CarnalMoss/Motorcontroller/motor-control/maybe-bom.xlsx

Bill of Materials |  | Senior Design |  | P16261 |  | Hardware V1 |  | 2016-01-22
Item Number | Quantity | Name /Description | web link | Quanitity Purchased | Price
Generated Using:
chdir C:\Users\terminator\Documents\classwork\senior design\repos\kicad\motor-control
C:\Program Files\KiCad\bin\xsltproc.exe -v -o outputfile.csv "C:\Program Files\KiCad\bin\scripting\plugins\bom2csv.xsl" _saved_motor-control.xml
"C:\Program Files\KiCad\bin\xsltproc.exe" -v -o motor-interface-rev1.csv "C:\Program Files\KiCad\bin\scripting\plugins\bom2csv.xsl" motor-interface-rev1.xml
 |  |  | Reference | Value | Footprint | Datasheet | Voltage
 |  |  | C1 | 470uF | Capacitors_ThroughHole:C_Radial_D16_L30_P7.5 | http://www.digikey.com/product-search/en?keywords=P5850-ND
 |  |  | C10 | 1uF | Capacitors_SMD:C_0805 |  | 6.3 V
 |  |  | C11 | 1uF | Capacitors_SMD:C_0805 |  | 10 V
 |  |  | C12 | 0.022uF | Capacitors_SMD:C_0805
 |  |  | C13 | 0.47nF | Capacitors_SMD:C_0805
 |  |  | C14 | 0.1uF | Capacitors_SMD:C_0805 |  | 10 V
 |  |  | C15 | 0.1uF | Capacitors_SMD:C_0805 |  | 16 V
 |  |  | C16 | 0.1uF | Capacitors_SMD:C_0805 |  | 100 V
 |  |  | C17 | 0.1uF | Capacitors_SMD:C_0805 |  | 16 V
 |  |  | C18 | 4.7uF | Capacitors_SMD:C_0805 |  | 100 V
 |  |  | C19 | 0.1uF | Capacitors_SMD:C_0805 |  | 16 V
 |  |  | C2 | 470uF | Capacitors_ThroughHole:C_Radial_D16_L30_P7.5 | http://www.digikey.com/product-search/en?keywords=P5850-ND
 |  |  | C20 | 47uF | Capacitors_SMD:C_0805 |  | 6.3 V
 |  |  | C21 | 4.7uF | Capacitors_SMD:C_0805 |  | 100 V
 |  |  | C3 | 470uF | Capacitors_ThroughHole:C_Radial_D16_L30_P7.5 | http://www.digikey.com/product-search/en?keywords=P5850-ND
 |  |  | C4 | 470uF | Capacitors_ThroughHole:C_Radial_D16_L30_P7.5 | http://www.digikey.com/product-search/en?keywords=P5850-ND
 |  |  | C5 | 470uF | Capacitors_ThroughHole:C_Radial_D16_L30_P7.5 | http://www.digikey.com/product-search/en?keywords=P5850-ND
 |  |  | C6 | 470uF | Capacitors_ThroughHole:C_Radial_D16_L30_P7.5 | http://www.digikey.com/product-search/en?keywords=P5850-ND
 |  |  | C7 | 2700 pF | Capacitors_SMD:C_0805
 |  |  | C8 | 6.8 pF | Capacitors_SMD:C_0805
 |  |  | C9 | 2.2uF | Capacitors_SMD:C_0805 |  | 16 V
 |  |  | D1 | D | Diodes_ThroughHole:Diode_TO-247_Vertical
 |  |  | L1 | 22uH | Inductors:INDUCTOR_V
 |  |  | P1 | CONN_02X12 | Pin_Headers:Pin_Header_Straight_2x12
 |  |  | P2 | to_motor_phase_1 | Connect:Banana_Jack_1Pin
 |  |  | P3 | to_motor_phase_2 | Connect:Banana_Jack_1Pin
 |  |  | P4 | to_motor_phase_3 | Connect:Banana_Jack_1Pin
 |  |  | P5 | CONN_01X01 | Connect:Banana_Jack_1Pin
 |  |  | P6 | CONN_01X01 | Connect:Banana_Jack_1Pin
 |  |  | P7 | CONN_01X04 | Pin_Headers:Pin_Header_Straight_1x04
 |  |  | Q1 | csd19505kcs | p16261:csd19505kcs | http://www.mouser.com/ProductDetail/Texas-Instruments/CSD19505KCS/?qs=%252bFzhjShcsaJOb21rbgU2rQ%3D%3D
 |  |  | Q10 | csd19505kcs | p16261:csd19505kcs | http://www.mouser.com/ProductDetail/Texas-Instruments/CSD19505KCS/?qs=%252bFzhjShcsaJOb21rbgU2rQ%3D%3D
 |  |  | Q11 | csd19505kcs | p16261:csd19505kcs | http://www.mouser.com/ProductDetail/Texas-Instruments/CSD19505KCS/?qs=%252bFzhjShcsaJOb21rbgU2rQ%3D%3D
 |  |  | Q12 | csd19505kcs | p16261:csd19505kcs | http://www.mouser.com/ProductDetail/Texas-Instruments/CSD19505KCS/?qs=%252bFzhjShcsaJOb21rbgU2rQ%3D%3D
 |  |  | Q2 | csd19505kcs | p16261:csd19505kcs | http://www.mouser.com/ProductDetail/Texas-Instruments/CSD19505KCS/?qs=%252bFzhjShcsaJOb21rbgU2rQ%3D%3D
 |  |  | Q3 | csd19505kcs | p16261:csd19505kcs | http://www.mouser.com/ProductDetail/Texas-Instruments/CSD19505KCS/?qs=%252bFzhjShcsaJOb21rbgU2rQ%3D%3D
 |  |  | Q4 | csd19505kcs | p16261:csd19505kcs | http://www.mouser.com/ProductDetail/Texas-Instruments/CSD19505KCS/?qs=%252bFzhjShcsaJOb21rbgU2rQ%3D%3D
 |  |  | Q5 | csd19505kcs | p16261:csd19505kcs | http://www.mouser.com/ProductDetail/Texas-Instruments/CSD19505KCS/?qs=%252bFzhjShcsaJOb21rbgU2rQ%3D%3D
 |  |  | Q6 | csd19505kcs | p16261:csd19505kcs | http://www.mouser.com/ProductDetail/Texas-Instruments/CSD19505KCS/?qs=%252bFzhjShcsaJOb21rbgU2rQ%3D%3D
 |  |  | Q7 | csd19505kcs | p16261:csd19505kcs | http://www.mouser.com/ProductDetail/Texas-Instruments/CSD19505KCS/?qs=%252bFzhjShcsaJOb21rbgU2rQ%3D%3D
 |  |  | Q8 | csd19505kcs | p16261:csd19505kcs | http://www.mouser.com/ProductDetail/Texas-Instruments/CSD19505KCS/?qs=%252bFzhjShcsaJOb21rbgU2rQ%3D%3D
 |  |  | Q9 | csd19505kcs | p16261:csd19505kcs | http://www.mouser.com/ProductDetail/Texas-Instruments/CSD19505KCS/?qs=%252bFzhjShcsaJOb21rbgU2rQ%3D%3D
 |  |  | R1 | DNP | Resistors_SMD:R_0805
 |  |  | R10 | 0R | Resistors_SMD:R_0805
 |  |  | R11 | 0R | Resistors_SMD:R_0805
 |  |  | R12 | .33R | Resistors_ThroughHole:Resistor_Vertical_RM7.5mm | http://www.mouser.com/ProductDetail/Yageo/SQP500JB-0R33/
 |  |  | R13 | .33R | Resistors_ThroughHole:Resistor_Vertical_RM7.5mm | http://www.mouser.com/ProductDetail/Yageo/SQP500JB-0R33/
 |  |  | R14 | 10R | Resistors_SMD:R_0805
 |  |  | R15 | 10R | Resistors_SMD:R_0805
 |  |  | R16 | .33R | Resistors_ThroughHole:Resistor_Vertical_RM7.5mm | http://www.mouser.com/ProductDetail/Yageo/SQP500JB-0R33/
 |  |  | R17 | 0R | Resistors_SMD:R_0805
 |  |  | R18 | 0R | Resistors_SMD:R_0805
 |  |  | R19 | .33R | Resistors_ThroughHole:Resistor_Vertical_RM7.5mm | http://www.mouser.com/ProductDetail/Yageo/SQP500JB-0R33/
 |  |  | R2 | DNP | Resistors_SMD:R_0805
 |  |  | R20 | .33R | Resistors_ThroughHole:Resistor_Vertical_RM7.5mm | http://www.mouser.com/ProductDetail/Yageo/SQP500JB-0R33/
 |  |  | R21 | .33R | Resistors_ThroughHole:Resistor_Vertical_RM7.5mm | http://www.mouser.com/ProductDetail/Yageo/SQP500JB-0R33/
 |  |  | R22 | 10R | Resistors_SMD:R_0805
 |  |  | R23 | 10R | Resistors_SMD:R_0805
 |  |  | R24 | 76.8k | Resistors_SMD:R_0805
 |  |  | R25 | 10k | Resistors_SMD:R_0805
 |  |  | R26 | 10k | Resistors_SMD:R_0805
 |  |  | R27 | 800k | Resistors_SMD:R_0805
 |  |  | R28 | 0R | Resistors_SMD:R_0805
 |  |  | R29 | 22k | Resistors_SMD:R_0805
 |  |  | R3 | 0R | Resistors_SMD:R_0805
 |  |  | R30 | 4k | Resistors_SMD:R_0805
 |  |  | R4 | 0R | Resistors_SMD:R_0805
 |  |  | R5 | .33R | Resistors_ThroughHole:Resistor_Vertical_RM7.5mm | http://www.mouser.com/ProductDetail/Yageo/SQP500JB-0R33/
 |  |  | R6 | .33R | Resistors_ThroughHole:Resistor_Vertical_RM7.5mm | http://www.mouser.com/ProductDetail/Yageo/SQP500JB-0R33/
 |  |  | R7 | 10R | Resistors_SMD:R_0805
 |  |  | R8 | 10R | Resistors_SMD:R_0805
 |  |  | R9 | .33R | Resistors_ThroughHole:Resistor_Vertical_RM7.5mm | http://www.mouser.com/ProductDetail/Yageo/SQP500JB-0R33/
 |  |  | U1 | ACS770 | p16261:ACS770xCB | http://www.digikey.com/product-search/en?keywords=ACS770LCB-050U-PFF-T
 |  |  | U2 | ACS770 | p16261:ACS770xCB | http://www.digikey.com/product-search/en?keywords=ACS770LCB-050U-PFF-T
 |  |  | U3 | ACS770 | p16261:ACS770xCB | http://www.digikey.com/product-search/en?keywords=ACS770LCB-050U-PFF-T
 |  |  | U4 | DRV8301 | p16261:DRV8301
 |  |  | U5 | ADT7301 | p16261:ADT7301
