CarnalMoss/Motorcontroller/motor-control/BOM-2-9-16-kicad-export.xlsx

Reference | Value | Footprint | Voltage | Datasheet
C8 | 0.01uF | Capacitors_SMD:C_0805 |  | http://www.mouser.com/Search/ProductDetail.aspx
C12 | 0.022uF | Capacitors_SMD:C_0805 |  | http://www.mouser.com/Search/ProductDetail.aspx
C23 | 0.047uF | Capacitors_SMD:C_0805 |  | http://www.mouser.com/ProductDetail/AVX/0805YC473KAT2A/
C25 | 0.047uF | Capacitors_SMD:C_0805 |  | http://www.mouser.com/ProductDetail/AVX/0805YC473KAT2A/
C27 | 0.047uF | Capacitors_SMD:C_0805 |  | http://www.mouser.com/ProductDetail/AVX/0805YC473KAT2A/
C14 | 0.1uF | Capacitors_SMD:C_0805 | 10 V
C15 | 0.1uF | Capacitors_SMD:C_0805 | 16 V
C17 | 0.1uF | Capacitors_SMD:C_0805 | 16 V
C19 | 0.1uF | Capacitors_SMD:C_0805 | 16 V
C22 | 0.1uF | Capacitors_SMD:C_0805 |  | http://www.mouser.com/ProductDetail/Kemet/C0805C104K3RACTU/
C24 | 0.1uF | Capacitors_SMD:C_0805 |  | http://www.mouser.com/ProductDetail/Kemet/C0805C104K3RACTU/
C26 | 0.1uF | Capacitors_SMD:C_0805 |  | http://www.mouser.com/ProductDetail/Kemet/C0805C104K3RACTU/
C13 | 0.47nF | Capacitors_SMD:C_0805
C7 | 10pF | Capacitors_SMD:C_0805 |  | http://www.mouser.com/ProductDetail/AVX/04025A100FAT2A/
C18 | 10uF | p16261:FK20X7S2A475K | 100 V | http://www.mouser.com/ProductDetail/TDK/FK20X7S2A475K/?qs=sGAEpiMZZMt3KoXD5rJ2N48tYEMqcp4xHF5PfUWuJkY%3d
C10 | 1uF | Capacitors_SMD:C_0805 | 6.3 V | http://www.mouser.com/ProductDetail/TDK/C2012X7S2A105K125AB/
C11 | 1uF | Capacitors_SMD:C_0805 | 10 V | http://www.mouser.com/ProductDetail/TDK/C2012X7S2A105K125AB/
C21 | 1uF | Capacitors_SMD:C_0805 | 100 V | http://www.mouser.com/ProductDetail/TDK/C2012X7S2A105K125AB/
C9 | 2.2uF | Capacitors_SMD:C_0805 | 16 V
C20 | 22uF | Capacitors_SMD:C_0805 | 6.3 V
C1 | 470uF | Capacitors_ThroughHole:C_Radial_D16_L30_P7.5 |  | http://www.digikey.com/product-search/en?keywords=P5850-ND
C2 | 470uF | Capacitors_ThroughHole:C_Radial_D16_L30_P7.5 |  | http://www.digikey.com/product-search/en?keywords=P5850-ND
C3 | 470uF | Capacitors_ThroughHole:C_Radial_D16_L30_P7.5 |  | http://www.digikey.com/product-search/en?keywords=P5850-ND
C4 | 470uF | Capacitors_ThroughHole:C_Radial_D16_L30_P7.5 |  | http://www.digikey.com/product-search/en?keywords=P5850-ND
C5 | 470uF | Capacitors_ThroughHole:C_Radial_D16_L30_P7.5 |  | http://www.digikey.com/product-search/en?keywords=P5850-ND
C6 | 470uF | Capacitors_ThroughHole:C_Radial_D16_L30_P7.5 |  | http://www.digikey.com/product-search/en?keywords=P5850-ND
C16 | DNP | Capacitors_SMD:C_0805 | 100 V
D1 | D | p16261:B220A-13-F |  | http://www.mouser.com/Search/ProductDetail.aspx?R=B220A-13-Fvirtualkey62110000virtualkey621-B220A-F
L1 | 68uH | p16261:PHC-27-683 |  | http://www.coilcraft.com/pdfs/pch.pdf
P5 | CONN_01X01 | Connect:Banana_Jack_1Pin
P6 | CONN_01X01 | Connect:Banana_Jack_1Pin
P7 | CONN_01X04 | Pin_Headers:Pin_Header_Straight_1x04
P1 | CONN_02X12 | Pin_Headers:Pin_Header_Straight_2x12
P2 | to_motor_phase_1 | Connect:Banana_Jack_1Pin
P3 | to_motor_phase_2 | Connect:Banana_Jack_1Pin
P4 | to_motor_phase_3 | Connect:Banana_Jack_1Pin
Q1 | csd19505kcs | p16261:csd19505kcs |  | http://www.mouser.com/ProductDetail/Texas-Instruments/CSD19505KCS/?qs=%252bFzhjShcsaJOb21rbgU2rQ%3D%3D
Q10 | csd19505kcs | p16261:csd19505kcs |  | http://www.mouser.com/ProductDetail/Texas-Instruments/CSD19505KCS/?qs=%252bFzhjShcsaJOb21rbgU2rQ%3D%3D
Q11 | csd19505kcs | p16261:csd19505kcs |  | http://www.mouser.com/ProductDetail/Texas-Instruments/CSD19505KCS/?qs=%252bFzhjShcsaJOb21rbgU2rQ%3D%3D
Q12 | csd19505kcs | p16261:csd19505kcs |  | http://www.mouser.com/ProductDetail/Texas-Instruments/CSD19505KCS/?qs=%252bFzhjShcsaJOb21rbgU2rQ%3D%3D
Q2 | csd19505kcs | p16261:csd19505kcs |  | http://www.mouser.com/ProductDetail/Texas-Instruments/CSD19505KCS/?qs=%252bFzhjShcsaJOb21rbgU2rQ%3D%3D
Q3 | csd19505kcs | p16261:csd19505kcs |  | http://www.mouser.com/ProductDetail/Texas-Instruments/CSD19505KCS/?qs=%252bFzhjShcsaJOb21rbgU2rQ%3D%3D
Q4 | csd19505kcs | p16261:csd19505kcs |  | http://www.mouser.com/ProductDetail/Texas-Instruments/CSD19505KCS/?qs=%252bFzhjShcsaJOb21rbgU2rQ%3D%3D
Q5 | csd19505kcs | p16261:csd19505kcs |  | http://www.mouser.com/ProductDetail/Texas-Instruments/CSD19505KCS/?qs=%252bFzhjShcsaJOb21rbgU2rQ%3D%3D
Q6 | csd19505kcs | p16261:csd19505kcs |  | http://www.mouser.com/ProductDetail/Texas-Instruments/CSD19505KCS/?qs=%252bFzhjShcsaJOb21rbgU2rQ%3D%3D
Q7 | csd19505kcs | p16261:csd19505kcs |  | http://www.mouser.com/ProductDetail/Texas-Instruments/CSD19505KCS/?qs=%252bFzhjShcsaJOb21rbgU2rQ%3D%3D
Q8 | csd19505kcs | p16261:csd19505kcs |  | http://www.mouser.com/ProductDetail/Texas-Instruments/CSD19505KCS/?qs=%252bFzhjShcsaJOb21rbgU2rQ%3D%3D
Q9 | csd19505kcs | p16261:csd19505kcs |  | http://www.mouser.com/ProductDetail/Texas-Instruments/CSD19505KCS/?qs=%252bFzhjShcsaJOb21rbgU2rQ%3D%3D
R12 | .33R | Resistors_ThroughHole:Resistor_Vertical_RM7.5mm |  | http://www.mouser.com/ProductDetail/Yageo/SQP500JB-0R33/
R13 | .33R | Resistors_ThroughHole:Resistor_Vertical_RM7.5mm |  | http://www.mouser.com/ProductDetail/Yageo/SQP500JB-0R33/
R16 | .33R | Resistors_ThroughHole:Resistor_Vertical_RM7.5mm |  | http://www.mouser.com/ProductDetail/Yageo/SQP500JB-0R33/
R19 | .33R | Resistors_ThroughHole:Resistor_Vertical_RM7.5mm |  | http://www.mouser.com/ProductDetail/Yageo/SQP500JB-0R33/
R20 | .33R | Resistors_ThroughHole:Resistor_Vertical_RM7.5mm |  | http://www.mouser.com/ProductDetail/Yageo/SQP500JB-0R33/
R21 | .33R | Resistors_ThroughHole:Resistor_Vertical_RM7.5mm |  | http://www.mouser.com/ProductDetail/Yageo/SQP500JB-0R33/
R5 | .33R | Resistors_ThroughHole:Resistor_Vertical_RM7.5mm |  | http://www.mouser.com/ProductDetail/Yageo/SQP500JB-0R33/
R6 | .33R | Resistors_ThroughHole:Resistor_Vertical_RM7.5mm |  | http://www.mouser.com/ProductDetail/Yageo/SQP500JB-0R33/
R9 | .33R | Resistors_ThroughHole:Resistor_Vertical_RM7.5mm |  | http://www.mouser.com/ProductDetail/Yageo/SQP500JB-0R33/
R10 | 0R | Resistors_SMD:R_0805
R11 | 0R | Resistors_SMD:R_0805
R17 | 0R | Resistors_SMD:R_0805
R18 | 0R | Resistors_SMD:R_0805
R28 | 0R | Resistors_SMD:R_0805 |  | http://www.mouser.com/ProductDetail/Panasonic/ERJ-6GEY0R00V/?qs=sGAEpiMZZMtlubZbdhIBIGGkozl1QdRpbM2mlUXXIDw%3d
R3 | 0R | Resistors_SMD:R_0805
R4 | 0R | Resistors_SMD:R_0805
R31 | 100R | Resistors_SMD:R_0805 |  | http://www.mouser.com/ProductDetail/Bourns/CRS0805-FX-1000ELF/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
R32 | 100R | Resistors_SMD:R_0805 |  | http://www.mouser.com/ProductDetail/Bourns/CRS0805-FX-1000ELF/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
R33 | 100R | Resistors_SMD:R_0805 |  | http://www.mouser.com/ProductDetail/Bourns/CRS0805-FX-1000ELF/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
R25 | 10k | Resistors_SMD:R_0805 |  | http://www.mouser.com/Search/ProductDetail.aspx
R26 | 10k | Resistors_SMD:R_0805 |  | http://www.mouser.com/Search/ProductDetail.aspx
R30 | 10k | Resistors_SMD:R_0805
R14 | 10R | Resistors_SMD:R_0805
R15 | 10R | Resistors_SMD:R_0805
R22 | 10R | Resistors_SMD:R_0805
R23 | 10R | Resistors_SMD:R_0805
R7 | 10R | Resistors_SMD:R_0805
R8 | 10R | Resistors_SMD:R_0805
R27 | 205k | Resistors_SMD:R_0603 |  | http://www.mouser.com/Search/ProductDetail.aspx
R24 | 24.3k | Resistors_SMD:R_0805
R29 | 53.6k | Resistors_SMD:R_0805
R1 | DNP | Resistors_SMD:R_0805
R2 | DNP | Resistors_SMD:R_0805
U1 | ACS770 | p16261:ACS770xCB |  | http://www.digikey.com/product-search/en?keywords=ACS770LCB-050U-PFF-T
U2 | ACS770 | p16261:ACS770xCB |  | http://www.digikey.com/product-search/en?keywords=ACS770LCB-050U-PFF-T
U3 | ACS770 | p16261:ACS770xCB |  | http://www.digikey.com/product-search/en?keywords=ACS770LCB-050U-PFF-T
U5 | ADT7301 | p16261:ADT7301
U4 | DRV8301 | p16261:DRV8301
