CarnalMoss/Motorcontroller/motor-interface/motor-interface-rev1.csv

Reference | Value | Footprint | Datasheet
C1 | .47uF | Capacitors_Tantalum_SMD:TantalC_SizeB_EIA-3528_Reflow | http://www.mouser.com/ProductDetail/AVX/TCJB474M063R0400/
C2 | 100uF | Capacitors_Tantalum_SMD:TantalC_SizeA_EIA-3216_Reflow | http://www.mouser.com/ProductDetail/Panasonic/6TPH100MAEA/
D1 | YELLOW | LEDs:LED-0805 | http://www.mouser.com/Search/ProductDetail.aspx
D2 | RED | LEDs:LED-0805 | http://www.mouser.com/Search/ProductDetail.aspx
D3 | GREEN | LEDs:LED-0805 | http://www.mouser.com/Search/ProductDetail.aspx
D4 | GREEN | LEDs:LED-0805 | http://www.mouser.com/Search/ProductDetail.aspx
P1 | CONN_02X12 | Pin_Headers:Pin_Header_Straight_2x12
P10 | CONN_01X03 | Pin_Headers:Pin_Header_Straight_1x03
P11 | CONN_01X04 | Pin_Headers:Pin_Header_Straight_1x04
P12 | CONN_01X03 | Pin_Headers:Pin_Header_Straight_1x03
P13 | CONN_01X03 | Pin_Headers:Pin_Header_Straight_1x03
P2 | CONN_02X10 | Pin_Headers:Pin_Header_Straight_2x10
P3 | CONN_01X03 | Pin_Headers:Pin_Header_Straight_1x03
P4 | CONN_02X10 | Pin_Headers:Pin_Header_Straight_2x10
P5 | CONN_01X04 | Pin_Headers:Pin_Header_Straight_1x04
P6 | CONN_01X04 | Pin_Headers:Pin_Header_Straight_1x04
P7 | CONN_01X04 | Pin_Headers:Pin_Header_Straight_1x04
P8 | CONN_01X01 | Pin_Headers:Pin_Header_Straight_1x01
P9 | CONN_01X03 | Pin_Headers:Pin_Header_Straight_1x03
Q1 | SI2325DS-T1-E3 | p16261:SI2325DS-T1-E3 | http://www.mouser.com/Search/ProductDetail.aspx
Q2 | SI2325DS-T1-E3 | p16261:SI2325DS-T1-E3 | http://www.mouser.com/Search/ProductDetail.aspx
R1 | 330R | Resistors_SMD:R_0603 | http://www.mouser.com/ProductDetail/Vishay-Dale/CRCW0603330RFKEAHP/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
R2 | 330R | Resistors_SMD:R_0603 | http://www.mouser.com/ProductDetail/Vishay-Dale/CRCW0603330RFKEAHP/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
R3 | EN_SO1 | Resistors_SMD:R_0603 | http://www.mouser.com/ProductDetail/Vishay-Dale/CRCW06030000Z0EA/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
R4 | EN_SO2 | Resistors_SMD:R_0603 | http://www.mouser.com/ProductDetail/Vishay-Dale/CRCW06030000Z0EA/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
R5 | 500R | Resistors_SMD:R_0603 | http://www.mouser.com/ProductDetail/Vishay-Dale/CRCW0603510RFKEA/
R6 | 330R | Resistors_SMD:R_0603 | http://www.mouser.com/ProductDetail/Vishay-Dale/CRCW0603330RFKEAHP/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
RV1 | POT | p16261:3361P | http://www.mouser.com/Search/ProductDetail.aspx
RV2 | POT | p16261:3361P | http://www.mouser.com/Search/ProductDetail.aspx
RV3 | POT | p16261:3361P | http://www.mouser.com/Search/ProductDetail.aspx
RV4 | POT | p16261:3361P | http://www.mouser.com/Search/ProductDetail.aspx
RV5 | POT | p16261:3361P | http://www.mouser.com/Search/ProductDetail.aspx
RV6 | POT | p16261:3361P | http://www.mouser.com/Search/ProductDetail.aspx
RV7 | POT | p16261:3361P | http://www.mouser.com/Search/ProductDetail.aspx
U1 | SN74LV1T34 | p16261:SN74LV1T34 | http://www.mouser.com/Search/ProductDetail.aspx
U2 | SN74LV1T34 | p16261:SN74LV1T34 | http://www.mouser.com/Search/ProductDetail.aspx
U3 | LM3940IS-3.3 | p16261:LM3940IS-3.3 | http://www.mouser.com/ProductDetail/Texas-Instruments/LM3940IS-33-NOPB/
U4 | SN74LV1T34 | p16261:SN74LV1T34 | http://www.mouser.com/Search/ProductDetail.aspx
U5 | SN74LV1T34 | p16261:SN74LV1T34 | http://www.mouser.com/Search/ProductDetail.aspx
U6 | SN74LV1T34 | p16261:SN74LV1T34 | http://www.mouser.com/Search/ProductDetail.aspx
U7 | SN74LV1T34 | p16261:SN74LV1T34 | http://www.mouser.com/Search/ProductDetail.aspx
U8 | SN74LV1T34 | p16261:SN74LV1T34 | http://www.mouser.com/Search/ProductDetail.aspx
U9 | SN74LV1T34 | p16261:SN74LV1T34 | http://www.mouser.com/Search/ProductDetail.aspx
