CarnalMoss/Motorcontroller/motor-interface/motor-interface-rev1.kicad_pcb

## KiCad design motor-interface/motor-interface-rev1.kicad_pcb (2016-04-03)

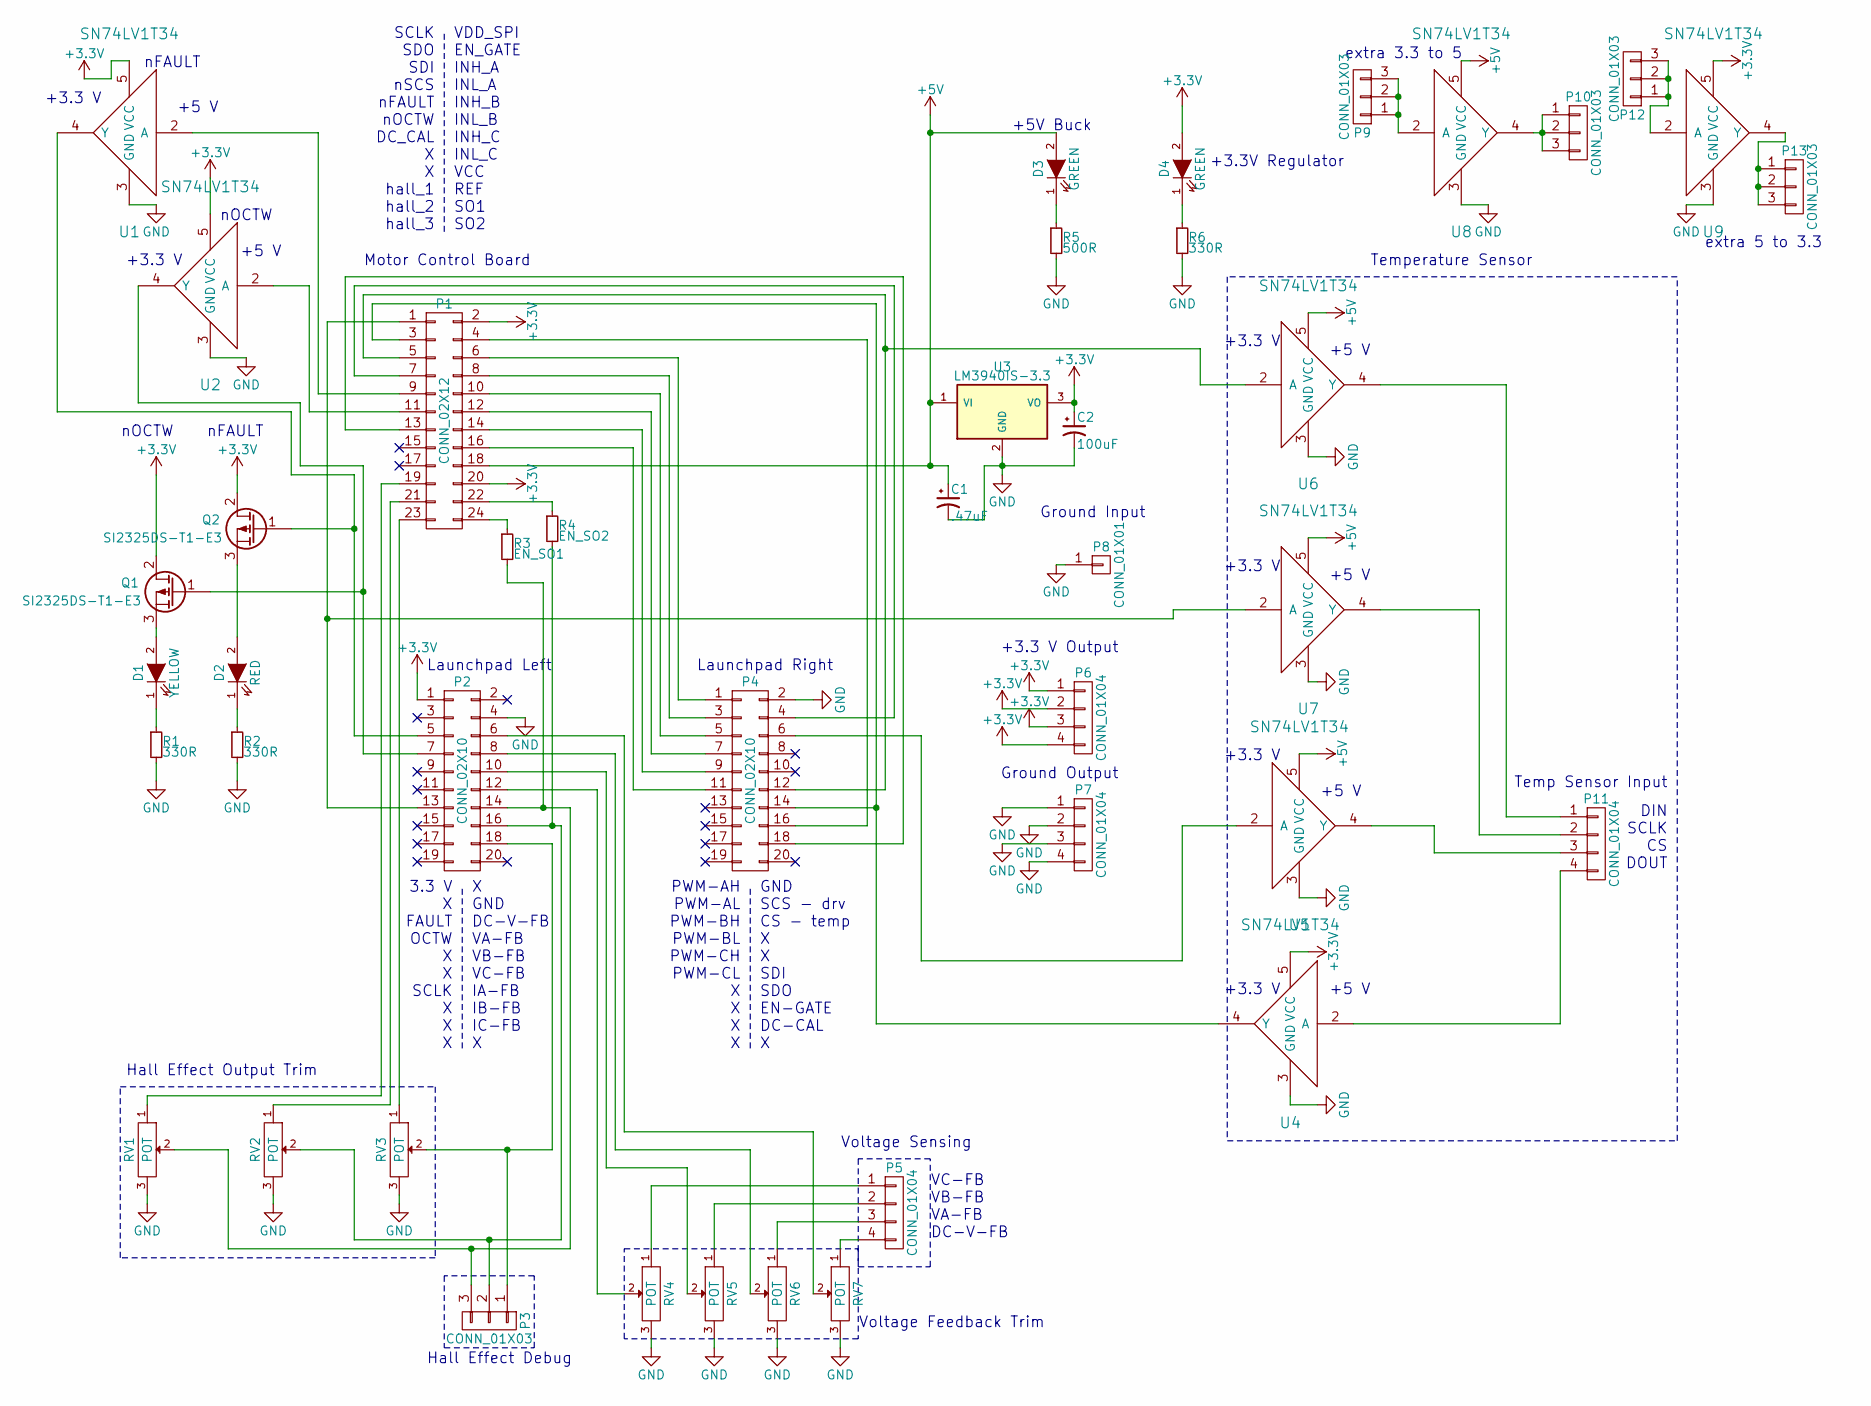
[picture p1: schematic motor-interface-rev1.sch, Motor Controller Interface Board]

Parts:
C1: .47uF; TantalC_SizeB_EIA-3528_Reflow
C2: 100uF; TantalC_SizeA_EIA-3216_Reflow
D1: YELLOW; LED-0805
D2: RED; LED-0805
D3, D4: GREEN; LED-0805
P1: CONN_02X12; Pin_Header_Straight_2x12
P2, P4: CONN_02X10; Pin_Header_Straight_2x10
P3, P9, P10, P12, P13: CONN_01X03; Pin_Header_Straight_1x03
P5, P6, P7, P11: CONN_01X04; Pin_Header_Straight_1x04
P8: CONN_01X01; Pin_Header_Straight_1x01
Q1, Q2: SI2325DS-T1-E3
R1, R2, R6: 330R; R_0603
R3: EN_SO1; R_0603
R4: EN_SO2; R_0603
R5: 500R; R_0603
RV1, RV2, RV3, RV4, RV5, RV6, RV7: POT; 3361P
U1, U2, U4, U5, U6, U7, U8, U9: SN74LV1T34
U3: LM3940IS-3.3

Connections:
+3V3: C2.1, D4.2 (A), P1.2, P1.20, P2.1, P6.1, P6.2, P6.3, P6.4, Q1.2 (D), Q2.2 (D), U1.5 (VCC), U2.5 (VCC), U3.3 (VO), U4.5 (VCC), U9.5 (VCC)
+5V: C1.1, D3.2 (A), P1.18, U3.1 (VI), U5.5 (VCC), U6.5 (VCC), U7.5 (VCC), U8.5 (VCC)
GND: C1.2, C2.2, P2.4, P4.2, P7.1, P7.2, P7.3, P7.4, P8.1, R1.2, R2.2, R5.2, R6.2, RV1.3, RV2.3, RV3.3, RV4.3, RV5.3, RV6.3, RV7.3, U1.3 (GND), U2.3 (GND), U3.2 (GND), U4.3 (GND), U5.3 (GND), U6.3 (GND), U7.3 (GND), U8.3 (GND), U9.3 (GND)
unnamed: D1.1 (K), R1.1
unnamed: D1.2 (A), Q1.3 (S)
unnamed: D2.1 (K), R2.1
unnamed: D2.2 (A), Q2.3 (S)
unnamed: D3.1 (K), R5.1
unnamed: D4.1 (K), R6.1
unnamed: P1.1, P2.13, U7.2 (A)
unnamed: P1.3, P4.14, U4.4 (Y)
unnamed: P1.4, P4.16
unnamed: P1.5, P4.12, U6.2 (A)
unnamed: P1.6, P4.1
unnamed: P1.7, P4.4
unnamed: P1.8, P4.3
unnamed: P1.9, U1.2 (A)
unnamed: P1.10, P4.5
unnamed: P1.11, U2.2 (A)
unnamed: P1.12, P4.7
unnamed: P1.13, P4.18
unnamed: P1.14, P4.9
unnamed: P1.16, P4.11
unnamed: P1.19, RV1.1
unnamed: P1.21, RV2.1
unnamed: P1.22, R4.1
unnamed: P1.23, RV3.1
unnamed: P1.24, R3.1
unnamed: P2.5, Q2.1 (G), U1.4 (Y)
unnamed: P2.6, RV7.2
unnamed: P2.7, Q1.1 (G), U2.4 (Y)
unnamed: P2.8, RV6.2
unnamed: P2.10, RV5.2
unnamed: P2.12, RV4.2
unnamed: P2.14, P3.3, R3.2, RV1.2
unnamed: P2.16, P3.2, R4.2, RV2.2
unnamed: P2.18, P3.1, RV3.2
unnamed: P4.6, U5.2 (A)
unnamed: P5.1, RV4.1
unnamed: P5.2, RV5.1
unnamed: P5.3, RV6.1
unnamed: P5.4, RV7.1
unnamed: P9.1, P9.2, P9.3, U8.2 (A)
unnamed: P10.1, P10.2, P10.3, U8.4 (Y)
unnamed: P11.1, U6.4 (Y)
unnamed: P11.2, U7.4 (Y)
unnamed: P11.3, U5.4 (Y)
unnamed: P11.4, U4.2 (A)
unnamed: P12.1, P12.2, P12.3, U9.2 (A)
unnamed: P13.1, P13.2, P13.3, U9.4 (Y)

Notes on the sheet:
X GND DC-V-FB VA-FB VB-FB VC-FB IA-FB IB-FB IC-FB X
3.3 V X FAULT OCTW X X SCLK X X X
GND SCS - drv CS - temp X X SDI SDO EN-GATE DC-CAL X
PWM-AH PWM-AL PWM-BH PWM-BL PWM-CH PWM-CL X X X X
VDD_SPI EN_GATE INH_A INL_A INH_B INL_B INH_C INL_C VCC REF SO1 SO2
SCLK SDO SDI nSCS nFAULT nOCTW DC_CAL X X hall_1 hall_2 hall_3
Ground Input
+3.3 V Output
Ground Output
Temp Sensor Input
DIN SCLK CS DOUT
Temperature Sensor
+3.3 V
+5 V
Hall Effect Output Trim
nOCTW
nFAULT
Hall Effect Debug
Voltage Sensing
VC-FB VB-FB VA-FB DC-V-FB
Voltage Feedback Trim
+5V Buck
+3.3V Regulator
Launchpad Left
Launchpad Right
Motor Control Board
extra 3.3 to 5
extra 5 to 3.3

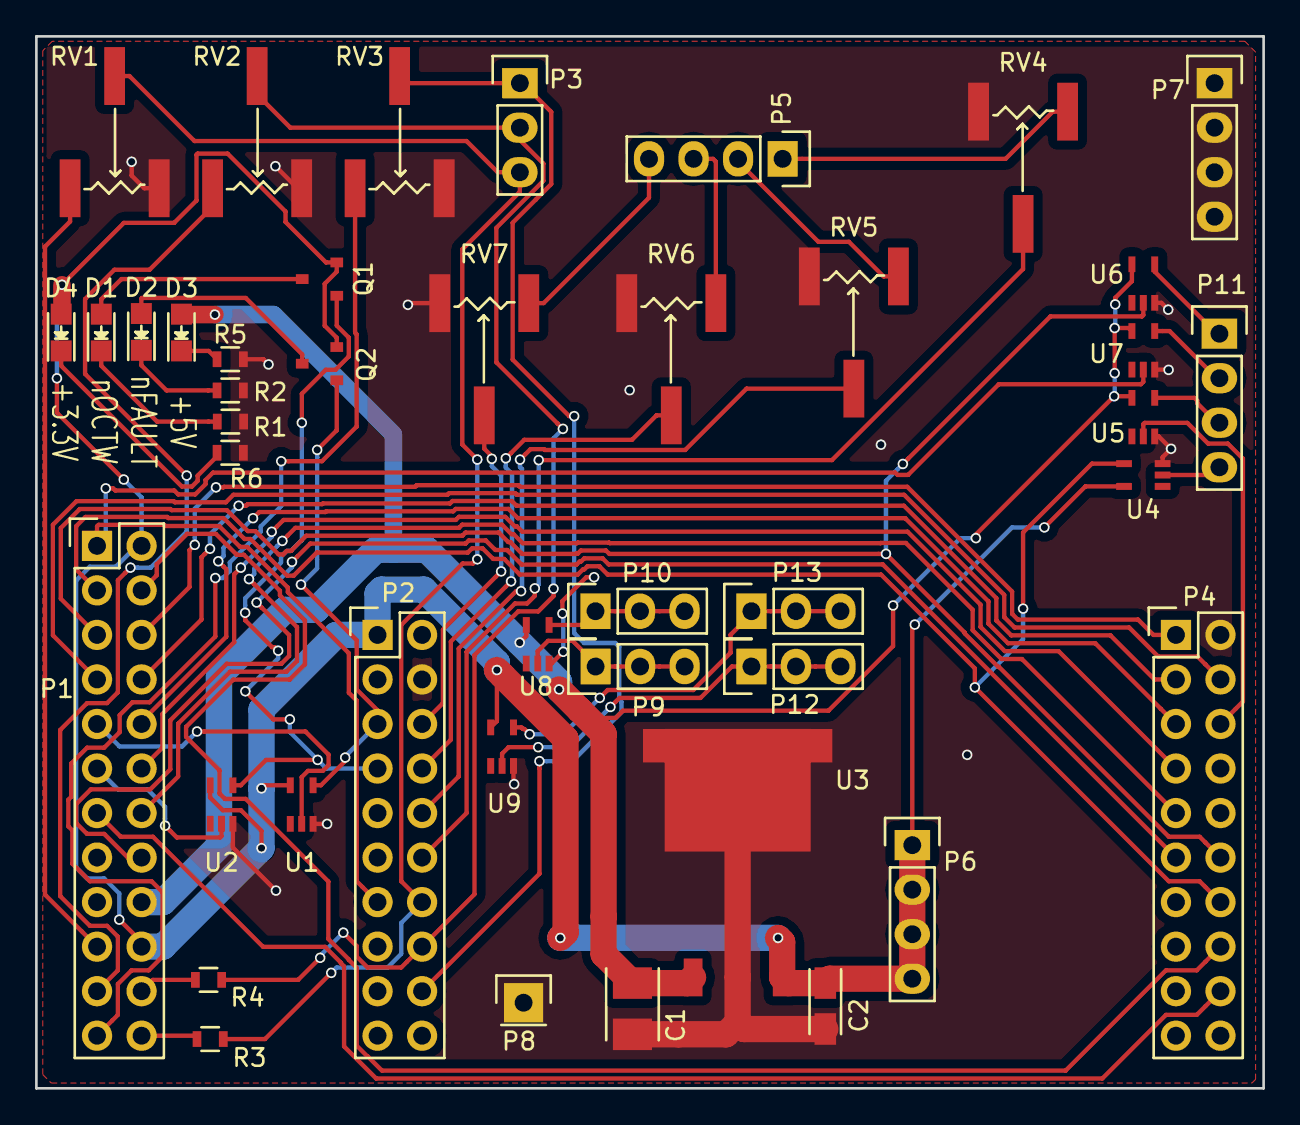
[picture p2: board motor-interface-rev1.kicad_pcb from above]

Board: 2 copper layers, 70.0 x 60.0 mm, 43 parts (0 on the bottom side), 50 nets.
