CarnalMoss/Motorcontroller/motor-control/_saved_motor-control.kicad_pcb

## KiCad design motor-control/_saved_motor-control.kicad_pcb (2015-12-08)

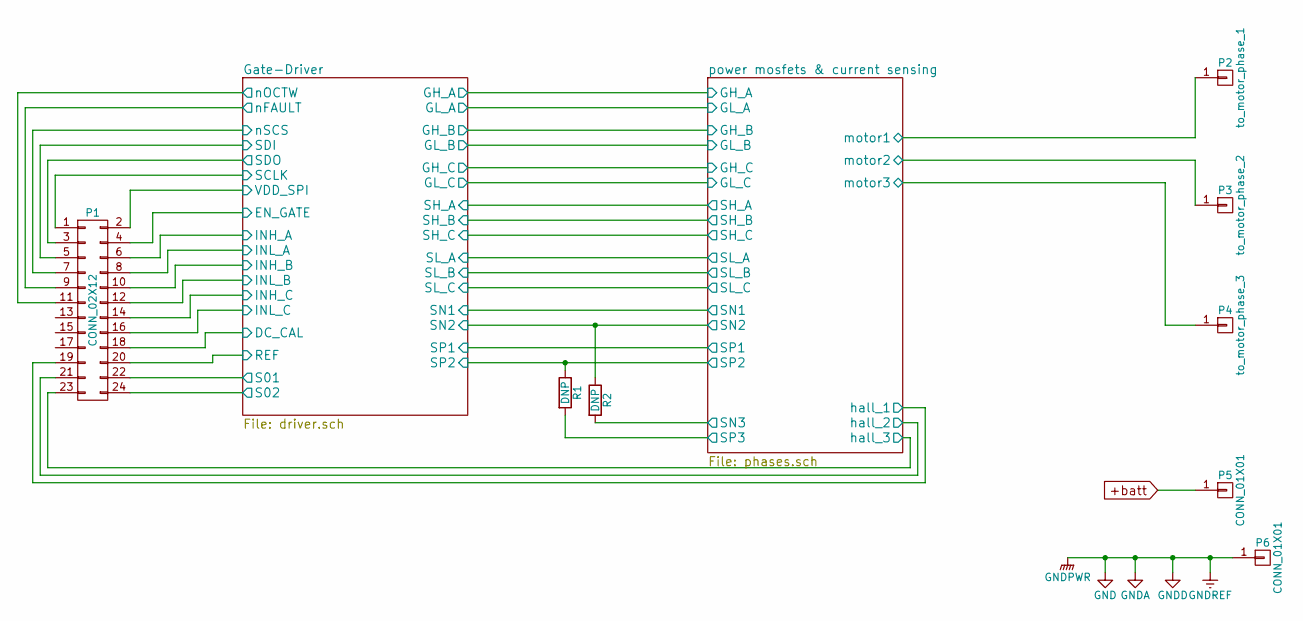
[picture p3: schematic _saved_motor-control.sch, P16261 Motor Controller Schematic -- Top Level]

Parts:
P1: CONN_02X12; Pin_Header_Straight_2x12
P2: to_motor_phase_1; Banana_Jack_1Pin
P3: to_motor_phase_2; Banana_Jack_1Pin
P4: to_motor_phase_3; Banana_Jack_1Pin
P5, P6: CONN_01X01; Pin_Header_Straight_1x01
R1, R2: DNP; R_0805

Connections:
+batt: P5.1; also elsewhere on the board
/Gate-Driver/DC_CAL: P1.18; also elsewhere on the board
/Gate-Driver/EN_GATE: P1.4; also elsewhere on the board
/Gate-Driver/INH_A: P1.6; also elsewhere on the board
/Gate-Driver/INH_B: P1.10; also elsewhere on the board
/Gate-Driver/INH_C: P1.14; also elsewhere on the board
/Gate-Driver/INL_A: P1.8; also elsewhere on the board
/Gate-Driver/INL_B: P1.12; also elsewhere on the board
/Gate-Driver/INL_C: P1.16; also elsewhere on the board
/Gate-Driver/REF: P1.20; also elsewhere on the board
/Gate-Driver/S01: P1.22; also elsewhere on the board
/Gate-Driver/S02: P1.24; also elsewhere on the board
/Gate-Driver/SCLK: P1.1; also elsewhere on the board
/Gate-Driver/SDI: P1.5; also elsewhere on the board
/Gate-Driver/SDO: P1.3; also elsewhere on the board
/Gate-Driver/SH_A: P2.1; also elsewhere on the board
/Gate-Driver/SH_B: P3.1; also elsewhere on the board
/Gate-Driver/SH_C: P4.1; also elsewhere on the board
/Gate-Driver/SN2: R2.1; also elsewhere on the board
/Gate-Driver/SP2: R1.1; also elsewhere on the board
/Gate-Driver/VDD_SPI: P1.2; also elsewhere on the board
/Gate-Driver/nFault: P1.9; also elsewhere on the board
/Gate-Driver/nOCTW: P1.11; also elsewhere on the board
/Gate-Driver/nSCS: P1.7; also elsewhere on the board
/power mosfets & current sensing/SN3: R2.2; also elsewhere on the board
/power mosfets & current sensing/SP3: R1.2; also elsewhere on the board
/power mosfets & current sensing/hall_1: P1.19; also elsewhere on the board
/power mosfets & current sensing/hall_2: P1.21; also elsewhere on the board
/power mosfets & current sensing/hall_3: P1.23; also elsewhere on the board
GND: P6.1; also elsewhere on the board

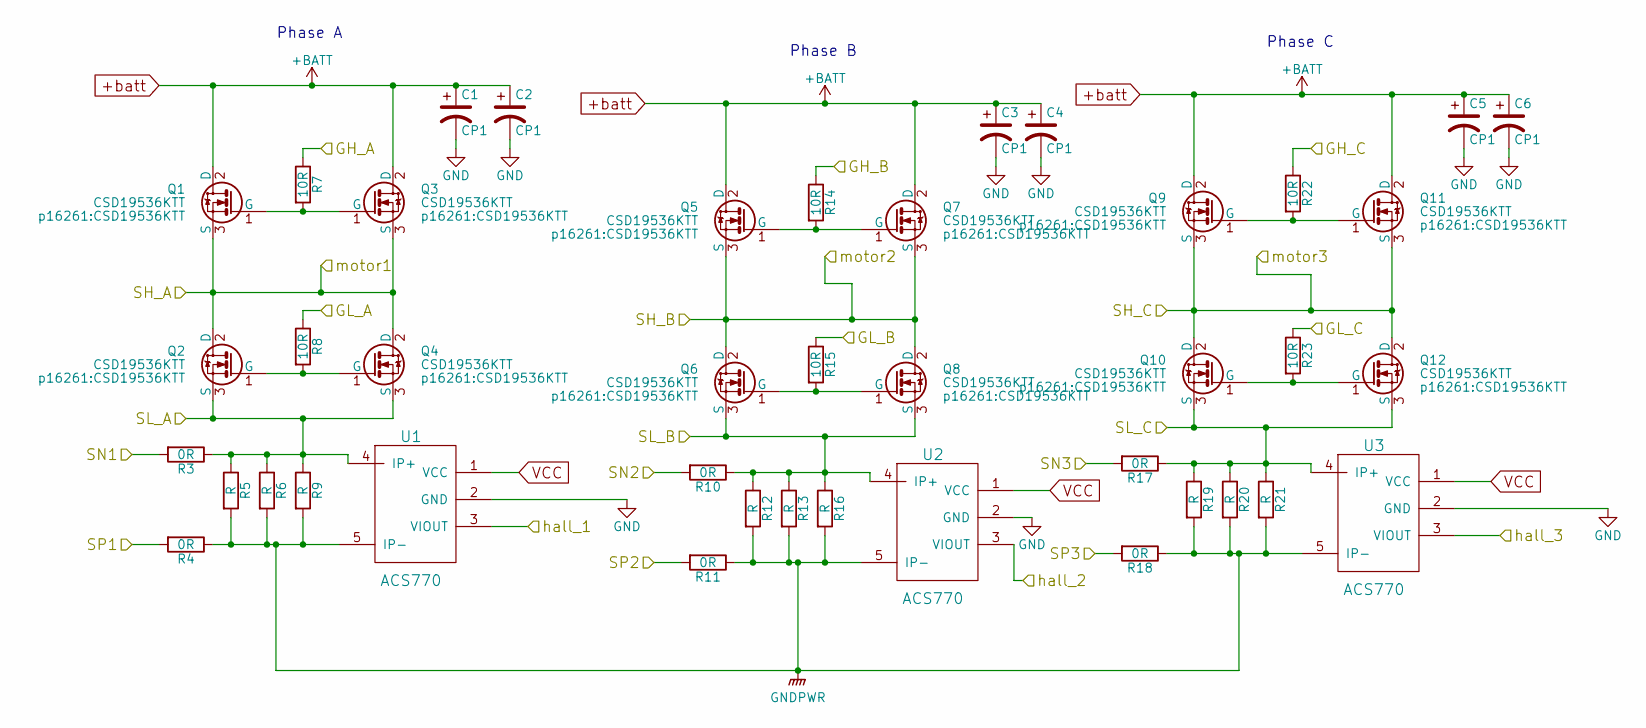
[picture p4: schematic phases.sch, Power MOSFETs]

Parts:
C1, C2, C3, C4, C5, C6: CP1; Elko_vert_31.5x16mm_RM7.5
Q1, Q2, Q3, Q4, Q5, Q6, Q7, Q8, Q9, Q10, Q11, Q12: CSD19536KTT
R3, R4, R10, R11, R17, R18: 0R; R_0805
R5, R6, R9, R12, R13, R16, R19, R20, R21: R; R_0805
R7, R8, R14, R15, R22, R23: 10R; R_0805
U1, U2, U3: ACS770; ACS770xCB

Connections:
+batt: C1.1, C2.1, C3.1, C4.1, C5.1, C6.1, Q1.2 (D), Q3.2 (D), Q5.2 (D), Q7.2 (D), Q9.2 (D), Q11.2 (D); also elsewhere on the board
/Gate-Driver/GH_A: R7.1; also elsewhere on the board
/Gate-Driver/GH_B: R14.1; also elsewhere on the board
/Gate-Driver/GH_C: R22.1; also elsewhere on the board
/Gate-Driver/GL_A: R8.1; also elsewhere on the board
/Gate-Driver/GL_B: R15.1; also elsewhere on the board
/Gate-Driver/GL_C: R23.1; also elsewhere on the board
/Gate-Driver/SH_A: Q1.3 (S), Q2.2 (D), Q3.3 (S), Q4.2 (D); also elsewhere on the board
/Gate-Driver/SH_B: Q5.3 (S), Q6.2 (D), Q7.3 (S), Q8.2 (D); also elsewhere on the board
/Gate-Driver/SH_C: Q9.3 (S), Q10.2 (D), Q11.3 (S), Q12.2 (D); also elsewhere on the board
/Gate-Driver/SL_A: Q2.3 (S), Q4.3 (S), R3.1, R5.1, R6.1, R9.1, U1.4 (IP+); also elsewhere on the board
/Gate-Driver/SL_B: Q6.3 (S), Q8.3 (S), R10.1, R12.1, R13.1, R16.1, U2.4 (IP+); also elsewhere on the board
/Gate-Driver/SL_C: Q10.3 (S), Q12.3 (S), R17.1, R19.1, R20.1, R21.1, U3.4 (IP+); also elsewhere on the board
/Gate-Driver/SN1: R3.2; also elsewhere on the board
/Gate-Driver/SN2: R10.2; also elsewhere on the board
/Gate-Driver/SP1: R4.2; also elsewhere on the board
/Gate-Driver/SP2: R11.2; also elsewhere on the board
/power mosfets & current sensing/SN3: R17.2; also elsewhere on the board
/power mosfets & current sensing/SP3: R18.2; also elsewhere on the board
/power mosfets & current sensing/hall_1: U1.3 (VIOUT); also elsewhere on the board
/power mosfets & current sensing/hall_2: U2.3 (VIOUT); also elsewhere on the board
/power mosfets & current sensing/hall_3: U3.3 (VIOUT); also elsewhere on the board
GND: C1.2, C2.2, C3.2, C4.2, C5.2, C6.2, R4.1, R5.2, R6.2, R9.2, R11.1, R12.2, R13.2, R16.2, R18.1, R19.2, R20.2, R21.2, U1.2 (GND), U1.5 (IP-), U2.2 (GND), U2.5 (IP-), U3.2 (GND), U3.5 (IP-); also elsewhere on the board
unnamed: Q1.1 (G), Q3.1 (G), R7.2
unnamed: Q2.1 (G), Q4.1 (G), R8.2
unnamed: Q5.1 (G), Q7.1 (G), R14.2
unnamed: Q6.1 (G), Q8.1 (G), R15.2
unnamed: Q10.1 (G), Q12.1 (G), R23.2
unnamed: Q9.1 (G), Q11.1 (G), R22.2
VCC: U1.1 (VCC), U2.1 (VCC), U3.1 (VCC); also elsewhere on the board

Notes on the sheet:
Phase A
Phase B
Phase C

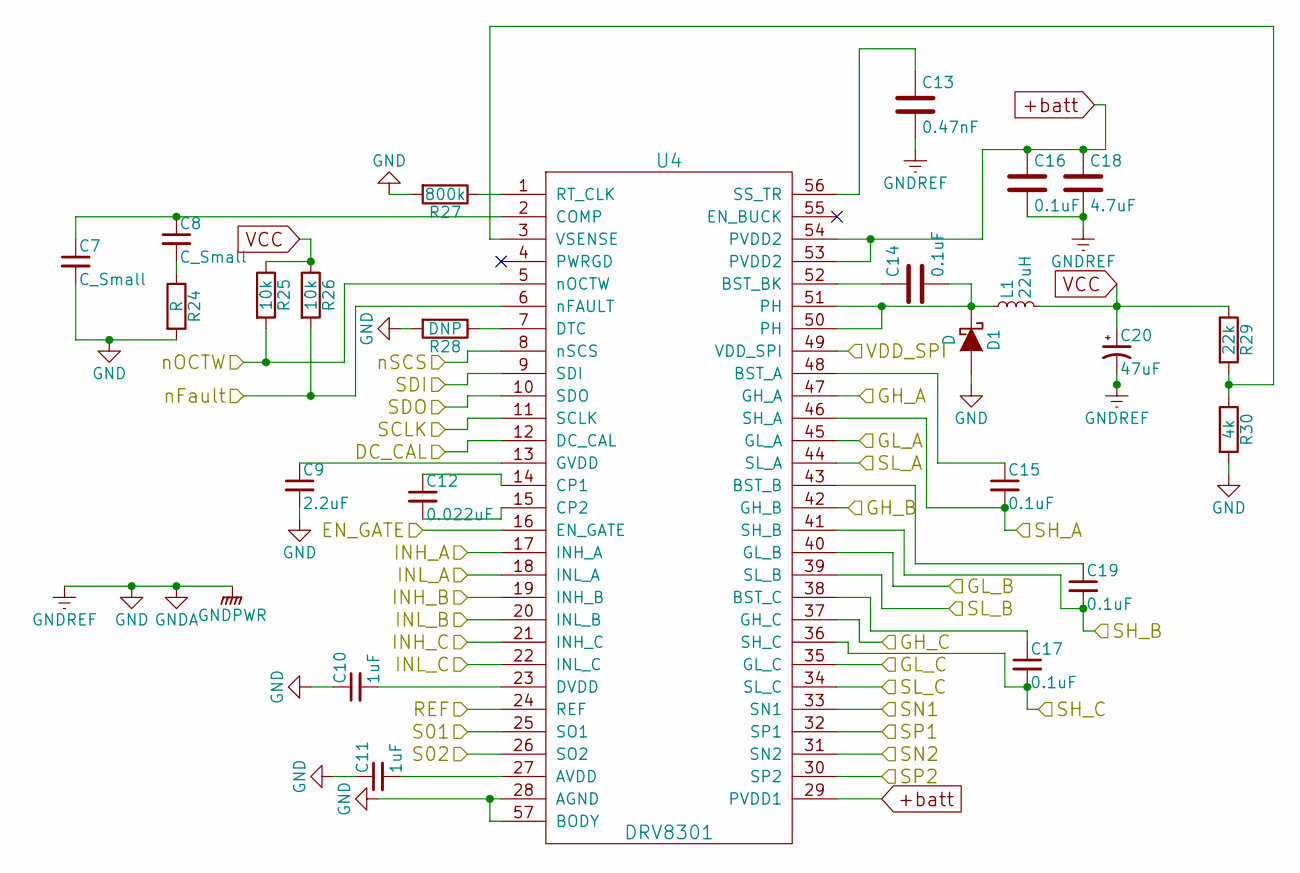
[picture p5: schematic driver.sch, Gate Driver Schematic]

Parts:
C7, C8: C_Small; C_0805
C9: 2.2uF; C_0805
C10, C11: 1uF; C_0805
C12: 0.022uF; C_0805
C13: 0.47nF; C_0805
C14, C15, C17, C19: 0.1uF; C_0805
C16: 0.1uF; Elko_vert_31.5x14mm_RM5
C18: 4.7uF; Elko_vert_31.5x16mm_RM7.5
C20: 47uF; Elko_vert_31.5x16mm_RM7.5
D1: D; C_0805
L1: 22uH; C_0805
R24: R; R_0805
R25, R26: 10k; R_0805
R27: 800k; R_0805
R28: DNP; R_0805
R29: 22k; R_0805
R30: 4k; R_0805
U4: DRV8301

Connections:
+batt: C16.1, C18.1, U4.29 (PVDD1), U4.53 (PVDD2), U4.54 (PVDD2); also elsewhere on the board
/Gate-Driver/DC_CAL: U4.12 (DC_CAL); also elsewhere on the board
/Gate-Driver/EN_GATE: U4.16 (EN_GATE); also elsewhere on the board
/Gate-Driver/GH_A: U4.47 (GH_A); also elsewhere on the board
/Gate-Driver/GH_B: U4.42 (GH_B); also elsewhere on the board
/Gate-Driver/GH_C: U4.37 (GH_C); also elsewhere on the board
/Gate-Driver/GL_A: U4.45 (GL_A); also elsewhere on the board
/Gate-Driver/GL_B: U4.40 (GL_B); also elsewhere on the board
/Gate-Driver/GL_C: U4.35 (GL_C); also elsewhere on the board
/Gate-Driver/INH_A: U4.17 (INH_A); also elsewhere on the board
/Gate-Driver/INH_B: U4.19 (INH_B); also elsewhere on the board
/Gate-Driver/INH_C: U4.21 (INH_C); also elsewhere on the board
/Gate-Driver/INL_A: U4.18 (INL_A); also elsewhere on the board
/Gate-Driver/INL_B: U4.20 (INL_B); also elsewhere on the board
/Gate-Driver/INL_C: U4.22 (INL_C); also elsewhere on the board
/Gate-Driver/REF: U4.24 (REF); also elsewhere on the board
/Gate-Driver/S01: U4.25 (SO1); also elsewhere on the board
/Gate-Driver/S02: U4.26 (SO2); also elsewhere on the board
/Gate-Driver/SCLK: U4.11 (SCLK); also elsewhere on the board
/Gate-Driver/SDI: U4.9 (SDI); also elsewhere on the board
/Gate-Driver/SDO: U4.10 (SDO); also elsewhere on the board
/Gate-Driver/SH_A: C15.2, U4.46 (SH_A); also elsewhere on the board
/Gate-Driver/SH_B: C19.2, U4.41 (SH_B); also elsewhere on the board
/Gate-Driver/SH_C: C17.2, U4.36 (SH_C); also elsewhere on the board
/Gate-Driver/SL_A: U4.44 (SL_A); also elsewhere on the board
/Gate-Driver/SL_B: U4.39 (SL_B); also elsewhere on the board
/Gate-Driver/SL_C: U4.34 (SL_C); also elsewhere on the board
/Gate-Driver/SN1: U4.33 (SN1); also elsewhere on the board
/Gate-Driver/SN2: U4.31 (SN2); also elsewhere on the board
/Gate-Driver/SP1: U4.32 (SP1); also elsewhere on the board
/Gate-Driver/SP2: U4.30 (SP2); also elsewhere on the board
/Gate-Driver/VDD_SPI: U4.49 (VDD_SPI); also elsewhere on the board
/Gate-Driver/nFault: R26.2, U4.6 (nFAULT); also elsewhere on the board
/Gate-Driver/nOCTW: R25.2, U4.5 (nOCTW); also elsewhere on the board
/Gate-Driver/nSCS: U4.8 (nSCS); also elsewhere on the board
GND: C7.2, C9.2, C10.1, C11.1, C13.2, C16.2, C18.2, C20.2, D1.2 (A), R24.2, R27.2, R28.2, R30.2, U4.28 (AGND), U4.57 (BODY); also elsewhere on the board
unnamed: C7.1, C8.1, U4.2 (COMP)
unnamed: C8.2, R24.1
unnamed: C9.1, U4.13 (GVDD)
unnamed: C10.2, U4.23 (DVDD)
unnamed: C11.2, U4.27 (AVDD)
unnamed: C12.1, U4.14 (CP1)
unnamed: C12.2, U4.15 (CP2)
unnamed: C13.1, U4.56 (SS_TR)
unnamed: C14.1, U4.52 (BST_BK)
unnamed: C14.2, D1.1 (K), L1.1, U4.50 (PH), U4.51 (PH)
unnamed: C15.1, U4.48 (BST_A)
unnamed: C17.1, U4.38 (BST_C)
unnamed: C19.1, U4.43 (BST_B)
unnamed: R27.1, U4.1 (RT_CLK)
unnamed: R28.1, U4.7 (DTC)
unnamed: R29.2, R30.1, U4.3 (VSENSE)
VCC: C20.1, L1.2, R25.1, R26.1, R29.1; also elsewhere on the board

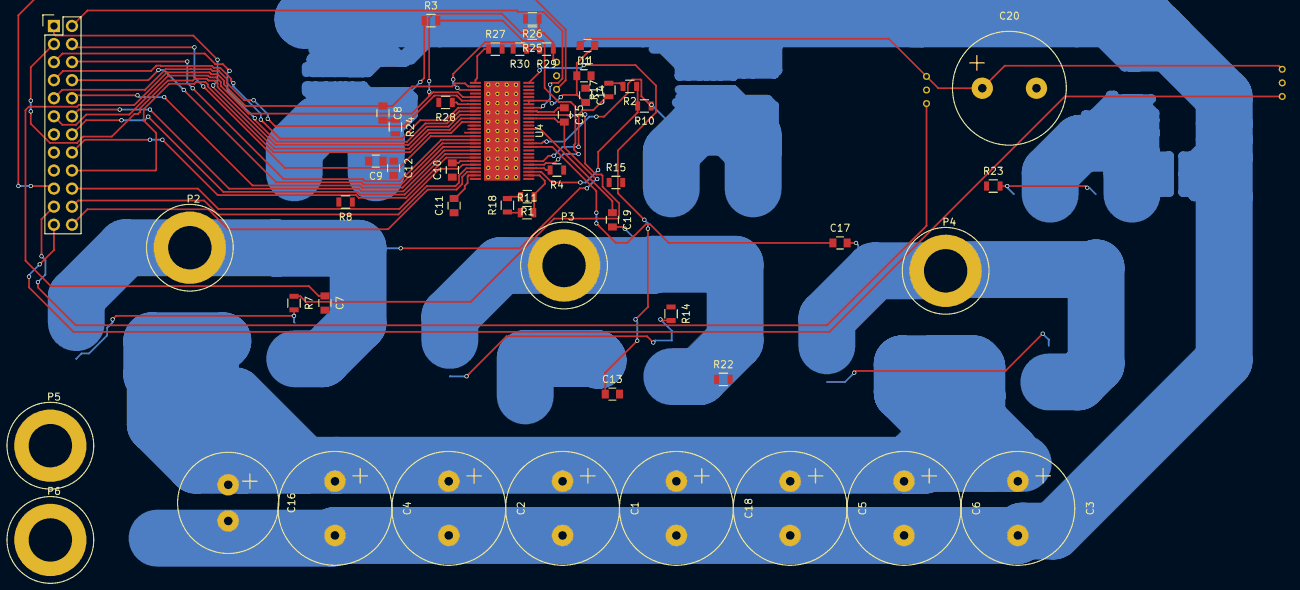
[picture p6: board _saved_motor-control.kicad_pcb from above]

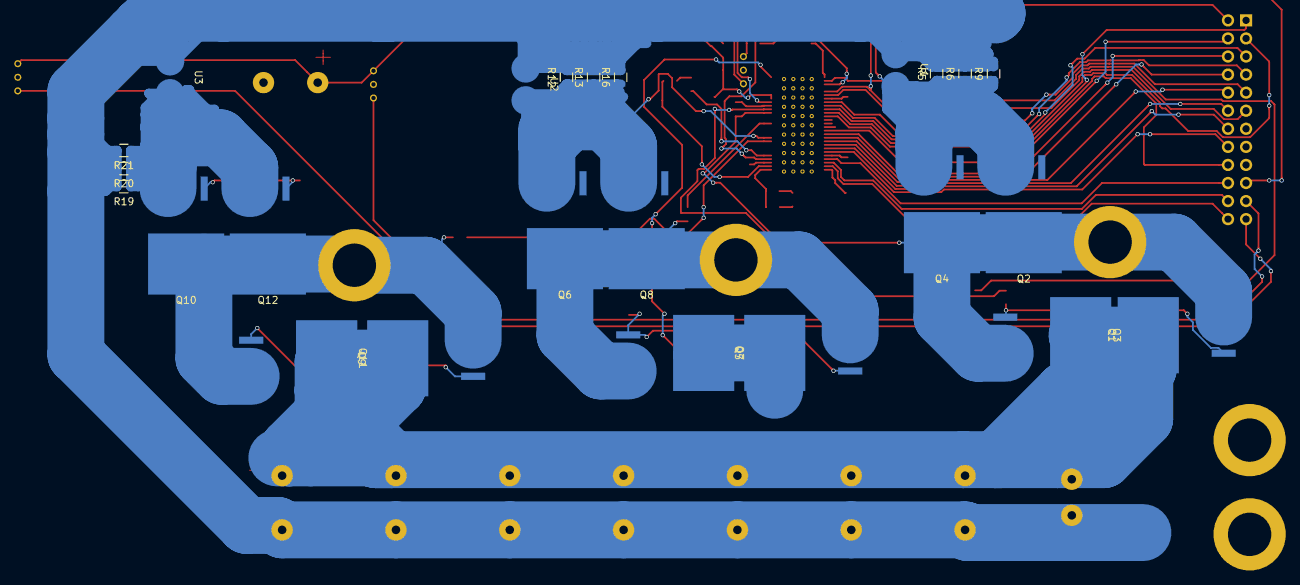
[picture p7: board _saved_motor-control.kicad_pcb from below]

Board: 2 copper layers, 74 parts (24 on the bottom side), 64 nets.
