CarnalMoss/Motorcontroller/(commit log)

2015-10-09 Added schematic and footprint of DRV8301
2015-10-30 Restructured project, libraries, footprints. pin57
    [_saved_motor-control.sch]
2015-11-01 Actually get rid of deleted files
    [_saved_motor-control.sch]
2015-11-10 Added mosfet to schematic, started making branches
2015-11-10 added mosfets sheet, & driver sheet
    [_saved_motor-control.sch, driver.sch, phases.sch]
2015-11-23 Almost finished gate driver schematic
    [_saved_motor-control.sch, driver.sch, phases.sch]
2015-11-23 Ready for pcb design. Schematic capture seems good
    [_saved_motor-control.sch]
2015-11-23 added hall current/pow-mos ftprnt, schmtc ttl edit
    [driver.sch]
2015-11-23 Annotated schematic & matched footprints
    [_saved_motor-control.sch, driver.sch, phases.sch]
2015-11-24 started the board layout
    [_saved_motor-control.kicad_pcb]
2015-11-30 more layout changes
    [_saved_motor-control.kicad_pcb]
2015-12-07 Significant board changes, fixed hall ftpnt
    [_saved_motor-control.kicad_pcb, _saved_motor-control.sch]
2015-12-07 Made prel design for back, started traces on front
    [_saved_motor-control.kicad_pcb]
2015-12-08 Started using autorouter push-and-shove
    [_saved_motor-control.kicad_pcb]
2015-12-08 More changes using autorouter. Finished connector
    [_saved_motor-control.kicad_pcb]
2015-12-27 started revision 2 of board, changed to thru fets
    [phases.sch]
2015-12-27 Added ftprnts frm kicad, other rev2 files
    [_saved_driver.sch, _saved_phases.sch, motor-control-rev2.kicad_pcb]
2015-12-28 Just trying to get things together
    [_saved_driver.sch, _saved_motor-control.sch, _saved_phases.sch, driver.sch, phases.sch]
2015-12-29 Rough design minus power and ground fills done
    [motor-control-rev2.kicad_pcb]
2016-01-06 Added VCC in shematic
    [_saved_motor-control.sch, motor-control-rev2.kicad_pcb]
2016-01-06 Added temp sensor ADT7301 sot-23
    [_saved_motor-control.sch, driver.sch, motor-control-rev2.kicad_pcb, phases.sch]
2016-01-07 Modified power layout extensively, moved vcc pin
    [_saved_motor-control.sch, motor-control-rev2.kicad_pcb]
2016-01-07 Added power ground and power traces
    [motor-control-rev2.kicad_pcb]
2016-01-07 Changing the non-power stuff
    [motor-control-rev2.kicad_pcb]
2016-01-09 More traces done on the digital side
    [motor-control-rev2.kicad_pcb]
2016-01-09 More changes
    [driver.sch, motor-control-rev2.kicad_pcb]
2016-01-09 Moved in all components, need last traces and GND
    [_saved_driver.sch, motor-control-rev2.kicad_pcb]
2016-01-09 All components in place, now to fix it up
    [motor-control-rev2.kicad_pcb]
2016-01-19 Stuff I didn't commit from last time
    [_saved_driver.sch, _saved_motor-control.sch, driver.sch, motor-control-rev2.kicad_pcb, phases.sch]
2016-01-19 Added Top Solder mask layer, redrew gnd plane
    [motor-control-rev2.kicad_pcb]
2016-01-19 Added bottom solder mask layer
    [motor-control-rev2.kicad_pcb]
2016-01-19 Redid board edge, increase copper&mask plane dist
    [motor-control-rev2.kicad_pcb]
2016-01-19 Almost! Added digital gnd, & connected some gnds
    [motor-control-rev2.kicad_pcb]
2016-01-20 Silkscreen round 1: oriented labels
    [motor-control-rev2.kicad_pcb]
2016-01-20 Added dimensions & wire jumper #s
    [motor-control-rev2.kicad_pcb]
2016-01-22 Modified Schematic Comp resist/cap vals, added bom
    [_saved_motor-control.xml, driver.sch, motor-control-rev2.kicad_pcb, outputfile.csv, phases.sch]
2016-01-23 Added some datasheet links, additional RC values
    [_saved_motor-control.xml, driver.sch, maybe-bom.xlsx, outputfile.csv, phases.sch]
2016-01-28 Updated BOM
    [_saved_motor-control.xml, maybe-bom.xlsx, outputfile.csv]
2016-02-02 Modified hall footprint, began replacement in pcb
    [motor-control-rev2.kicad_pcb]
2016-02-02 Started Spacing the fets
    [motor-control-rev2.kicad_pcb]
2016-02-02 Continued FET movement and spacing 1st reg good
    [motor-control-rev2.kicad_pcb]
2016-02-03 Connected grounds, moved temp sensor, some silk
    [motor-control-rev2.kicad_pcb]
2016-02-03 Moved a batt pin up left, began right hall fixes
    [motor-control-rev2.kicad_pcb]
2016-02-04 Finished right side mosfet separation
    [motor-control-rev2.kicad_pcb]
2016-02-04 Added hall filtering/bypass, part #s, associations
    [phases.sch]
2016-02-04 Added hall filtering components to pcb
    [motor-control-rev2.kicad_pcb]
2016-02-04 Began rework bottom fets spacing
    [motor-control-rev2.kicad_pcb]
2016-02-04 Cont. work on bottom fets, fixed a no conn. on drv
    [motor-control-rev2.kicad_pcb]
2016-02-04 Continued work on bottom fets. Fixed a zone on top
    [motor-control-rev2.kicad_pcb]
2016-02-04 Finished up bottom fets
    [motor-control-rev2.kicad_pcb]
2016-02-04 Chnaged schematic buck values according to TI
    [_saved_motor-control.sch, driver.sch, phases.sch]
2016-02-04 Added values in schematic, new diode&induct ftpnts
    [driver.sch]
2016-02-05 Updated pcb diode and inductor, placed them
    [motor-control-rev2.kicad_pcb]
2016-02-05 rid bad 3d, add new cap thruhole, add datasht lnks
    [_saved_motor-control.sch, driver.sch, motor-control-rev2.kicad_pcb, phases.sch]
2016-02-08 Fixd*1 ground(hall): added trace to other hall gnd
    [motor-control-rev2.kicad_pcb]
2016-02-08 Power FETs spaced apart without fixing it up
    [motor-control-rev2.kicad_pcb]
2016-02-09 fixd bottm sect trans spacing, upped via 1.7x1.016
    [motor-control-rev2.kicad_pcb]
2016-02-09 Top fets spacing & vias fixed
    [motor-control-rev2.kicad_pcb]
2016-02-09 Finished right side fets & vias
    [motor-control-rev2.kicad_pcb]
2016-02-09 Sized up hopefully all conn. vias to 1.7/1.016mm
    [motor-control-rev2.kicad_pcb]
2016-02-09 added front soldermask to all connecting vias
    [motor-control-rev2.kicad_pcb]
2016-02-09 Added four mounting holes
    [motor-control-rev2.kicad_pcb]
2016-02-09 Slightly moved hall up, moved fab text, some silk
    [motor-control-rev2.kicad_pcb]
2016-02-09 Added back silk credits. may be error w/ proj.file
    [motor-control-rev2.kicad_pcb]
2016-02-09 fixed error where conn via 7 hit +batt
    [motor-control-rev2.kicad_pcb]
2016-02-09 Don't know
    [motor-control-rev2.kicad_pcb]
2016-02-10 Added BOM file
    [BOM-2-9-16-kicad-export.xlsx, _saved_motor-control.xml]
2016-02-10 Unknown changes, maybe as result of plotting gerbe
    [motor-control-rev2.kicad_pcb]
2016-02-18 rem vcc via, cng via size, fxd drc except internal
    [motor-control-rev3.kicad_pcb]
2016-02-19 updated drv8301 via. sent design state to advanced
    [motor-control-rev3.kicad_pcb]
2016-03-21 Started Work on interface auxiliary board
    [motor-interface-rev1.kicad_pcb, motor-interface-rev1.sch]
2016-03-22 Done with 1st pass of interface board schematic
    [motor-interface-rev1.sch]
2016-03-22 Performed annotation, added 2 missing gnds
    [maybe-bom.xlsx, motor-interface-rev1.sch]
2016-03-22 Added BOM files
    [motor-interface-rev1.csv, motor-interface-rev1.xml]
2016-03-30 Added 3.3V conn to launch, added pots&volt.sensing
    [motor-interface-rev1.sch]
2016-04-02 Created board outline
    [motor-interface-rev1.kicad_pcb]
2016-04-02 Added keepouts, progress on layout
    [motor-interface-rev1.kicad_pcb, motor-interface-rev1.sch]
2016-04-03 Finished inital track laying. still need gnd fill
    [motor-interface-rev1.kicad_pcb]
2016-04-03 put in fills, moved f.fab, all connections made
    [motor-interface-rev1.kicad_pcb]
2016-04-03 Added some datasheet links for completeness
    [motor-interface-rev1.csv, motor-interface-rev1.kicad_pcb, motor-interface-rev1.sch, motor-interface-rev1.xml]
